EduardoPaz01/AE-Tijolos/(list of files, drawings)

Other design files:
AE.eprj
AE_II/eletrica/AE.eprj
