EduardoPaz01/AE-Tijolos/AE_IV/controlador/src/rede/portal_cativo.hpp

#ifndef PORTAL_CATIVO_HPP
#define PORTAL_CATIVO_HPP

#include "../../controlador.hpp"

// Redireciona qualquer requisição HTTP para a página principal do portal cativo.
void handleCaptivePortalRedirect();

// Redireciona qualquer requisição HTTP para a página principal do portal cativo.
void handleNotFound();

#endif // PORTAL_CATIVO_HPP
