EduardoPaz01/AE-Tijolos/(commit log)

2026-10-15 [misc] Organização de arquivos
    Reestruturado para suportar todos os módulos do 1 ao 5
2026-10-15 [feature] Adicionado banco de dados
2026-10-15 [feature] Adidicionado parte do controlador dedicado as Máquinas de Estados
2026-10-15 [feature] Adicionado controlador dedicado a parte de redes
2026-10-22 [misc] Remoção de arquivos para merge das bibliotecas de controle e rede
2026-10-22 [misc] Adicionado arquivos do controlador da parte de controle
2026-10-22 [misc] Adicionado arquivos de utilidades
    Arquivos responsáveis para auxilio da parte de rede
2026-10-22 [misc] Adicionado arquivos de rede
    Arquivos responsáveis pelas funções de rede, já retiifacados para funcinar na estrutura parcionada
2026-10-22 [misc] Adicionado arquivo da serial para parte de rede
2026-10-22 [misc] Adicionado arquivo .ino
    Arquivo já retificado para suportar os recursos do controle com rede
2026-10-22 [misc] Adicionado header do .ino
    Arquivo já retificado para suportar as inclusões em arquivos sucessivos
2026-10-22 [feature] Adicionado suporte genérico a função lcd
    Adicionado escopo para dar suporte a configuração do lcd
2026-10-22 [feature] Construido header para lcd com as prototipações
2026-10-22 [feature] Implementado funções de impressão do lcd para suportar o chamado do print_ip
2026-10-22 [misc] Correção da main
    Corrigido main para suporte da estrutura de chamada do lcd e do nome para ser suportado pela Arduino IDE
2026-10-29 [feature] Added gitignore
    Adicionado restrições para análise de modificações em arquivos do projeto
2026-10-29 [misc] Added new board
    Adicionado diagrama da nova placa esp32s3, já com os pinos devidamente configurados.
2026-10-29 [misc] Updated controlador file
    Removido laço de controle do código principal
2026-10-29 [misc] Fixed adc functions
    Corrigido arquivos responsávei pelo print de adc, de forma que fique responsável pela leitura do ADC, e o print adc seja feito pela biblioteca com a abstração da IDE.
2026-10-29 [misc] Added prototypes related to the control loop
    Adicionado prototipações
2026-10-29 [misc] Edited control loop function
    Editada função para receber vetor de pontos e conseguir seguir referencia de receitas, não só de rampas isoladas.
2026-10-29 [WP] Added test for the controller in parallelized core
    Adicinoado dummy para testar controle de forma provisória.
